ee-herrerar/EL3313-Proyecto2/docs/diseno/Imagenes/DiagramaBloquesGlobal.png

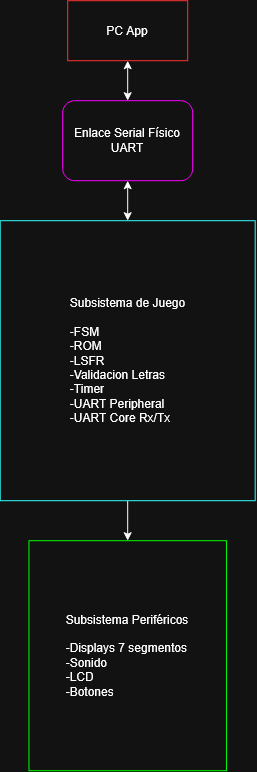
docs/diseno/Imagenes/DiagramaBloquesGlobal.png
