ee-herrerar/EL3313-Proyecto2/docs/diseno/Imagenes/generador_palabras_aleatorias-diagrama.png

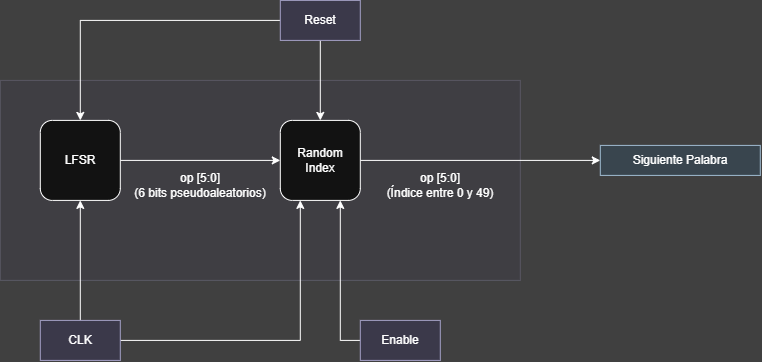
docs/diseno/Imagenes/generador_palabras_aleatorias-diagrama.png
