ee-herrerar/EL3313-Proyecto2/modulos/src/Juego/Timer.sv

module Timer (
    input  logic       clk,
    input  logic       rst,
    input  logic       hardmode,
    input  logic       GameOn,
    input  logic       Active,
    output logic [5:0] TimerS,
    output logic       TimeOut
);

    logic GameOnPrev;
    logic [16:0] ContadorCiclos;
    logic [10:0] ContadorMs;

    always_ff @(posedge clk or posedge rst) begin
        if (rst) begin
            ContadorCiclos <= 17'd0;
            ContadorMs <= 11'd0;
            GameOnPrev <= 1'b0;
            TimerS <= 6'd0;
            TimeOut <= 1'b0;
        end
        else begin
            GameOnPrev <= GameOn;

            if (GameOn && !GameOnPrev) begin
                ContadorCiclos <= 17'd0;
                ContadorMs <= 11'd0;
                TimeOut <= 1'b0;

                if (hardmode) begin
                    TimerS <= 6'd45;
                end
                else begin
                    TimerS <= 6'd60;
                end
            end
            else if (Active) begin
                if (ContadorCiclos == 17'd99999) begin
                    ContadorCiclos <= 17'd0;

                    if (ContadorMs == 11'd999) begin
                        ContadorMs <= 11'd0;

                        if (TimerS == 6'd1) begin
                            TimerS <= 6'd0;
                            TimeOut <= 1'b1;
                        end
                        else if (TimerS > 6'd1) begin
                            TimerS <= TimerS - 6'd1;
                        end
                    end
                    else begin
                        ContadorMs <= ContadorMs + 11'd1;
                    end
                end
                else begin
                    ContadorCiclos <= ContadorCiclos + 17'd1;
                end
            end
            else begin
                ContadorCiclos <= 17'd0;
                ContadorMs <= 11'd0;
            end
        end
    end

endmodule
