ee-herrerar/EL3313-Proyecto2/(commit log)

2026-09-02 UART y Generador Baudios
2026-09-05 Modulos UART con MM
2026-09-05 Avance UART_mm y renames
2026-09-07 Add LEDStatus module
2026-09-07 LCD actualización
    Added detailed explanation of the LCD subsystem, including its functionality during game stages and state machine operations.
2026-09-07 Diagrama de Nivel
2026-09-07 Dimensiones de LCD
    Updated image sizes in the state machine and LCD level sections.
2026-09-14 Union de todos los sistemas
2026-09-14 Cambios LCD para los requisitos
2026-09-16 Update informe.md with additional sections
    Added sections on game control and peripherals including UART, LCD, and indicators.
2026-09-17 Enhance design document with module details and diagrams
    Added detailed descriptions and diagrams for the buzzer and LED modules, including inputs, outputs, and functionality explanations.
2026-09-17 Enhance documentation for LED module and LCD subsystem
    Added detailed descriptions of the LED module and LCD subsystem functionality, including input/output specifications and state machine overview.
2026-09-17 Links de demostración
2026-09-17 Agregar apartado UART
    Updated the technical report for Project 2: Ahorcado, detailing the design and implementation of the game on the FPGA Basys 3, including system architecture, testing results, and theoretical foundations.
2026-09-17 Change header format for UART section
    Updated section headers for clarity in the design document.
2026-09-17 Revise design document for game modules
    Updated sections on ROM, LFSR, and Timer modules. Added details on the validation of letters and UART communication.
2026-09-17 Update design document with subsystem details
    Added details about the game's subsystem and UART communication.
2026-09-17 LCD actualización de diseño
    Added detailed descriptions of state machines for LCD subsystem, including initialization, control, and game flow. Updated sections for levels 1 to 4 with objectives and explanations.
